upenn-embedded/final-project-s26-t9/src/esp32/main/main.ino

#include "driver/spi_slave.h"
#include <Arduino.h>
#include <WiFi.h>
#include <esp_now.h>

#define CMD_START_COLL 0xA1
#define CMD_MOVE_DATA  0xB1
#define PKT_CMD        0xA1
#define PKT_ADDR       0xA2
#define PKT_MOVE       0xB1

#define MAX_ROBOTS       4
#define NUM_PHT          6
#define DATA_LEN         (MAX_ROBOTS * NUM_PHT * 2) /* 24 bytes */
#define MOVE_PAYLOAD_LEN (MAX_ROBOTS * 4)           /* dir+dist per robot, 8 bytes */

#define COLLECT_TIMEOUT 200
#define SPI_BUF_SIZE    200

/* ── ESP-NOW packets ─────────────────────────────────────────────────── */
struct EspDataPacket {
    uint8_t type;
    uint8_t robot_addr;
    uint8_t pad[2];
    uint8_t data[DATA_LEN]; /* ADC payload, 24 bytes */
};

struct EspMovePacket {
    uint8_t type; /* PKT_MOVE */
    uint8_t pad[3];
    uint8_t data[MOVE_PAYLOAD_LEN]; /* [dir0_lo][dir0_hi][dist0_lo][dist0_hi]... */
};

/* ── Globals ─────────────────────────────────────────────────────────── */
static const uint8_t broadcast[6] = {0xFF, 0xFF, 0xFF, 0xFF, 0xFF, 0xFF};

static uint8_t *rx1 = nullptr, *tx1 = nullptr;
static uint8_t *rx2 = nullptr, *tx2 = nullptr;

static uint8_t collected_data[MAX_ROBOTS][DATA_LEN];
static uint8_t collected_from[MAX_ROBOTS];
volatile uint8_t collected_count = 0;

/* ── Forward declarations ────────────────────────────────────────────── */
void start_collect();
void handle_move_data(const uint8_t *move_payload, uint8_t payload_len);

/* ── ESP-NOW receive callback ────────────────────────────────────────── */
void
onEspNowReceive(const esp_now_recv_info_t *info, const uint8_t *data, int len) {
    if (len < 4)
        return;
    const EspDataPacket *pkt = (const EspDataPacket *) data;

    if (pkt->type == PKT_ADDR && len >= (int) sizeof(EspDataPacket)) {
        if (collected_count < MAX_ROBOTS) {
            uint8_t slot = collected_count;
            collected_from[slot] = pkt->robot_addr;
            memcpy(collected_data[slot], pkt->data, DATA_LEN);
            collected_count++;
        }
    }
}

void
setup() {}

/* ── Main loop — receives either CMD_START_COLL or CMD_MOVE_DATA ─────── */
void
loop() {
    static bool initialized = false;

    if (!initialized) {
        Serial.begin(115200);

        WiFi.mode(WIFI_STA);
        WiFi.disconnect();

        if (esp_now_init() != ESP_OK) {
            Serial.println("[MAIN ESP32] ERROR: esp_now_init failed");
            while (true)
                delay(1000);
        }
        esp_now_register_recv_cb(onEspNowReceive);

        esp_now_peer_info_t peer = {};
        memcpy(peer.peer_addr, broadcast, 6);
        peer.channel = 0;
        peer.encrypt = false;
        if (esp_now_add_peer(&peer) != ESP_OK) {
            Serial.println("[MAIN ESP32] ERROR: esp_now_add_peer failed");
            while (true)
                delay(1000);
        }

        rx1 = (uint8_t *) heap_caps_malloc(SPI_BUF_SIZE, MALLOC_CAP_DMA);
        tx1 = (uint8_t *) heap_caps_malloc(SPI_BUF_SIZE, MALLOC_CAP_DMA);
        rx2 = (uint8_t *) heap_caps_malloc(SPI_BUF_SIZE, MALLOC_CAP_DMA);
        tx2 = (uint8_t *) heap_caps_malloc(SPI_BUF_SIZE, MALLOC_CAP_DMA);
        if (!rx1 || !tx1 || !rx2 || !tx2) {
            Serial.println("[MAIN ESP32] ERROR: DMA malloc failed");
            while (true)
                delay(1000);
        }

        spi_bus_config_t buscfg = {};
        buscfg.mosi_io_num = 17;
        buscfg.miso_io_num = 33;
        buscfg.sclk_io_num = 18;
        buscfg.quadwp_io_num = -1;
        buscfg.quadhd_io_num = -1;

        spi_slave_interface_config_t slvcfg = {};
        slvcfg.mode = 0;
        slvcfg.spics_io_num = 5;
        slvcfg.queue_size = 2;
        slvcfg.flags = 0;

        if (spi_slave_initialize(SPI3_HOST, &buscfg, &slvcfg, SPI_DMA_CH_AUTO) != ESP_OK) {
            Serial.println("[MAIN ESP32] ERROR: spi_slave_initialize failed");
            while (true)
                delay(1000);
        }

        initialized = true;
        delay(1000);
        Serial.println("[MAIN ESP32] Ready. MAC: " + WiFi.macAddress());
    }

    /* ── Wait for any SPI transaction from ATmega ── */
    memset(tx1, 0xFF, SPI_BUF_SIZE);
    memset(rx1, 0x00, SPI_BUF_SIZE);

    spi_slave_transaction_t trans1 = {};
    trans1.length = SPI_BUF_SIZE * 8;
    trans1.tx_buffer = tx1;
    trans1.rx_buffer = rx1;

    spi_slave_queue_trans(SPI3_HOST, &trans1, portMAX_DELAY);
    spi_slave_transaction_t *ret1;
    spi_slave_get_trans_result(SPI3_HOST, &ret1, portMAX_DELAY);

    /* rx1[0] = payload length, rx1[1] = command byte */
    uint8_t cmd = rx1[1];

    if (cmd == CMD_START_COLL) {
        start_collect();
        return;
    }

    if (cmd == CMD_MOVE_DATA) {
        /*
         * ATmega's move_buf = [CMD_MOVE_DATA][dir0_lo][dir0_hi][dist0_lo][dist0_hi]
         *                      [dir1_lo][dir1_hi][dist1_lo][dist1_hi]
         * spi_send_message prepends length, so:
         *   rx1[0] = 9 (payload length)
         *   rx1[1] = CMD_MOVE_DATA
         *   rx1[2..9] = move data
         */
        uint8_t payload_len = rx1[0] - 1; /* subtract the command byte itself */
        handle_move_data(&rx1[2], payload_len);
        return;
    }

    Serial.printf("[MAIN ESP32] Unexpected: len=0x%02X cmd=0x%02X — ignoring\n", rx1[0], rx1[1]);
}

/* ── Collect ADC data from sub ESP32s and send back to ATmega ────────── */
void
start_collect() {
    Serial.println("[MAIN ESP32] CMD_START_COLL received from ATmega");

    collected_count = 0;
    memset(collected_data, 0, sizeof(collected_data));
    memset(collected_from, 0xFF, sizeof(collected_from));

    EspDataPacket cmd_pkt;
    cmd_pkt.type = PKT_CMD;
    cmd_pkt.robot_addr = 0;
    cmd_pkt.pad[0] = 0;
    cmd_pkt.pad[1] = 0;
    memset(cmd_pkt.data, 0, DATA_LEN);
    esp_now_send(broadcast, (uint8_t *) &cmd_pkt, sizeof(cmd_pkt));
    Serial.println("[MAIN ESP32] CMD_START_COLL broadcast via ESP-NOW");

    delay(COLLECT_TIMEOUT);

    uint8_t snap_count = collected_count;
    uint8_t snap_from[MAX_ROBOTS];
    uint8_t snap_data[MAX_ROBOTS][DATA_LEN];
    memcpy(snap_from, collected_from, snap_count);
    memcpy(snap_data, collected_data, snap_count * DATA_LEN);

    Serial.printf("[MAIN ESP32] Collected %u robot(s)\n", snap_count);
    for (uint8_t r = 0; r < snap_count; r++) {
        Serial.printf("  Robot 0x%02X:", snap_from[r]);
        for (uint8_t b = 0; b < DATA_LEN; b++)
            Serial.printf(" %02X", snap_data[r][b]);
        Serial.println();
    }

    memset(tx2, 0xFF, SPI_BUF_SIZE);
    memset(rx2, 0x00, SPI_BUF_SIZE);

    uint8_t payload_len = 1 + snap_count * (1 + DATA_LEN);
    tx2[0] = payload_len;
    tx2[1] = snap_count;
    uint8_t *p = tx2 + 2;
    for (uint8_t r = 0; r < snap_count; r++) {
        *p++ = snap_from[r];
        memcpy(p, snap_data[r], DATA_LEN);
        p += DATA_LEN;
    }
    memset(p, 0xFF, SPI_BUF_SIZE - (p - tx2));

    spi_slave_transaction_t trans2 = {};
    trans2.length = SPI_BUF_SIZE * 8;
    trans2.tx_buffer = tx2;
    trans2.rx_buffer = rx2;

    spi_slave_queue_trans(SPI3_HOST, &trans2, portMAX_DELAY);
    spi_slave_transaction_t *ret2;
    spi_slave_get_trans_result(SPI3_HOST, &ret2, portMAX_DELAY);

    Serial.println("[MAIN ESP32] Response sent to ATmega — cycle complete\n");
}

/* ── Forward MOVE_DATA to all sub ESP32s via ESP-NOW ─────────────────── */
void
handle_move_data(const uint8_t *move_payload, uint8_t payload_len) {
    if (payload_len < MOVE_PAYLOAD_LEN) {
        Serial.printf("[MAIN ESP32] ERR: move payload too short (%u < %u)\n", payload_len, (unsigned) MOVE_PAYLOAD_LEN);
        return;
    }

    EspMovePacket pkt;
    pkt.type = PKT_MOVE;
    pkt.pad[0] = 0;
    pkt.pad[1] = 0;
    pkt.pad[2] = 0;
    memcpy(pkt.data, move_payload, MOVE_PAYLOAD_LEN);

    esp_now_send(broadcast, (uint8_t *) &pkt, sizeof(pkt));

    Serial.printf("[MAIN ESP32] MOVE_DATA broadcast — robot0 dir=%u dist=%u\n", (uint16_t) (move_payload[0] | (move_payload[1] << 8)), (uint16_t) (move_payload[2] | (move_payload[3] << 8)));
}
