upenn-embedded/final-project-s26-t9/test/esp-atmega/esp32/esp32_spi_master.ino

/*
 * ESP32 SPI Master Test
 * Sends 0xAB to ATmega slave every second, prints the response.
 *
 * Wiring (VSPI):
 *   ESP32 GPIO18 (SCK)  -> ATmega PB5 (SCK)
 *   ESP32 GPIO33 (MISO) -> ATmega PB4 (MISO)
 *   ESP32 GPIO17 (MOSI) -> ATmega PB3 (MOSI)
 *   ESP32 GPIO5  (SS)   -> ATmega PB2 (SS)
 *   GND <-> GND
 */

#include <SPI.h>

#define SCK_PIN  18
#define MISO_PIN 33
#define MOSI_PIN 17
#define SS_PIN    5

void setup() {
    // intentionally empty — project constraint
}

void loop() {
    static bool initialized = false;

    if (!initialized) {
        Serial.begin(115200);
        while (!Serial) {}

        SPI.begin(SCK_PIN, MISO_PIN, MOSI_PIN, SS_PIN);
        pinMode(SS_PIN, OUTPUT);
        digitalWrite(SS_PIN, HIGH);

        initialized = true;
        Serial.println("ESP32 SPI master ready");
    }

    uint8_t tx = 0xAB;
    uint8_t rx;

    SPI.beginTransaction(SPISettings(1000000, MSBFIRST, SPI_MODE0));
    digitalWrite(SS_PIN, LOW);
    rx = SPI.transfer(tx);
    digitalWrite(SS_PIN, HIGH);
    SPI.endTransaction();

    Serial.printf("Sent: 0x%02X  Received: 0x%02X\n", tx, rx);

    delay(1000);
}
