upenn-embedded/final-project-s26-t9/(commit log)

2026-04-16 spi comm fix
2026-04-16 spi test
2026-04-16 Updated GPIO bindings for ESP32 spi
    [main.ino, sub.ino]
2026-04-16 commented out printfs
2026-04-17 Added i2c basics
2026-04-17 finally fixed spi
2026-04-20 Completed next phase: added reading adc distance values and send back to main atmega
2026-04-20 Created graph representation and movement data from adc phototransistors
