upenn-embedded/final-project-s26-t9/assets/final/IMG_5664.png

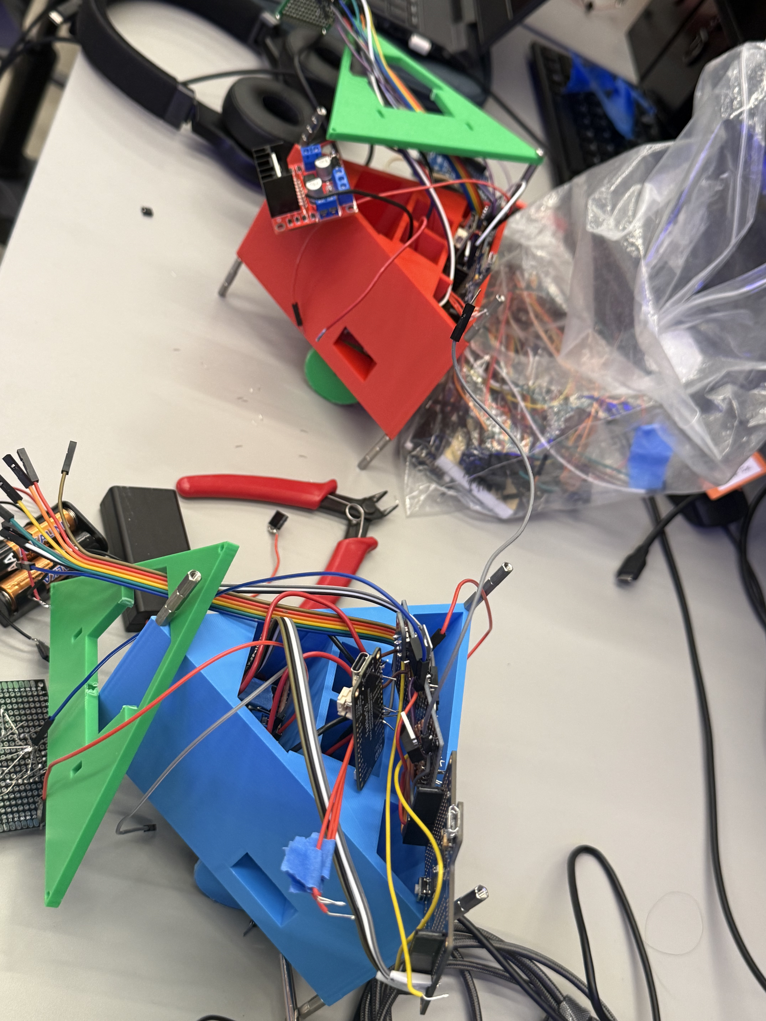
[picture p12: assets/final/IMG_5664.png]
assets/final/IMG_5664.png
