upenn-embedded/final-project-s26-t9/assets/final/IMG_5667.png

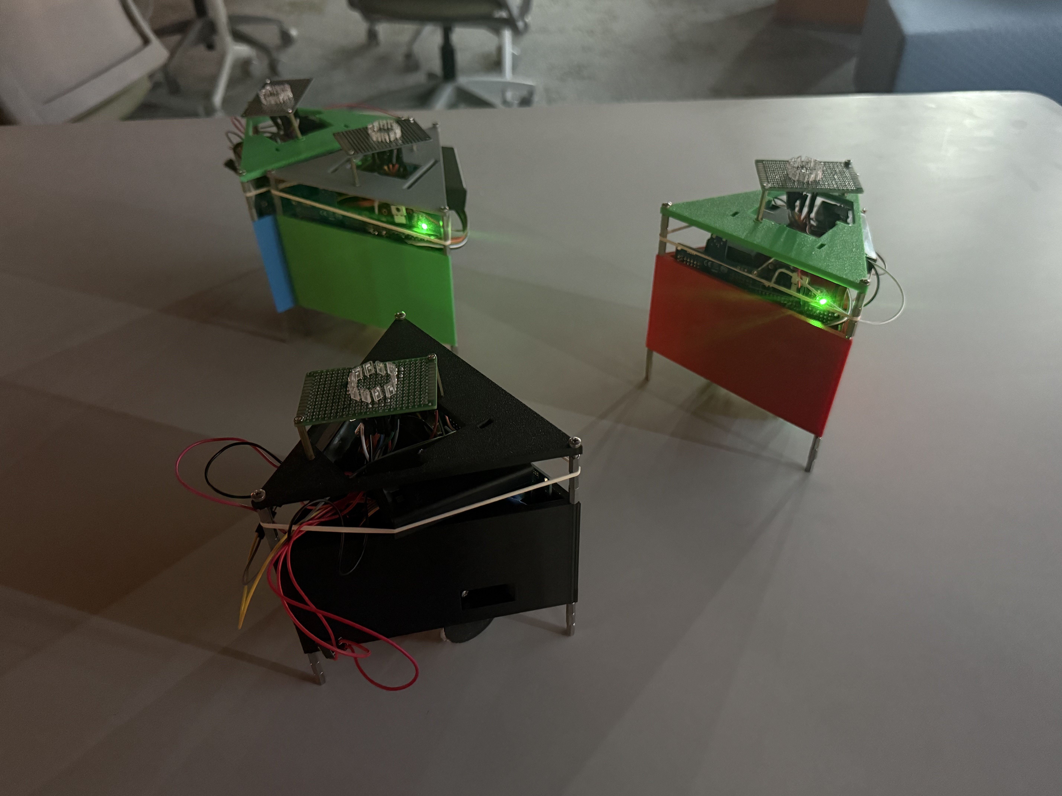
[picture p13: assets/final/IMG_5667.png]
assets/final/IMG_5667.png
